Gladi-vae/Project-Team-A---Taquin/Images/AI.png

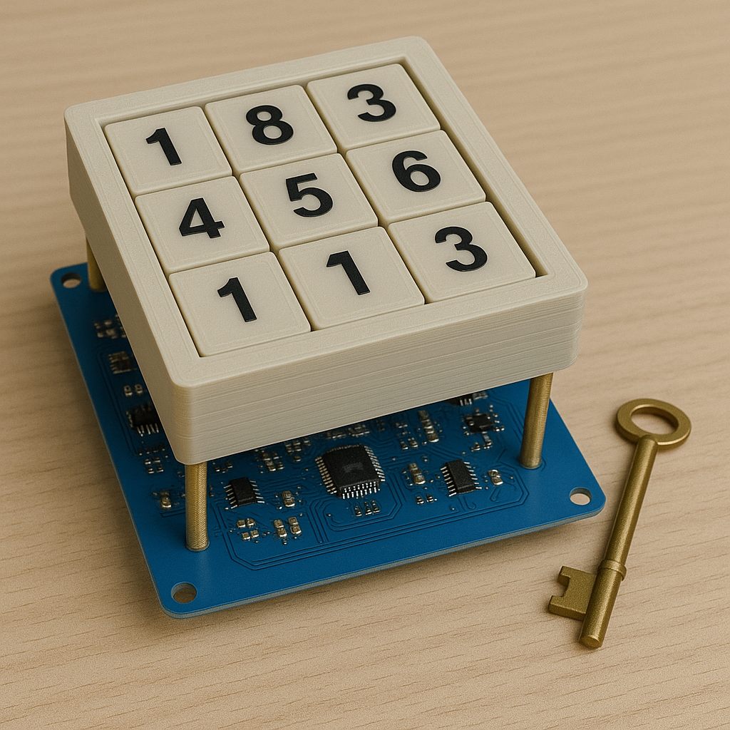
Images/AI.png
