Gladi-vae/Project-Team-A---Taquin/(commit log)

2025-05-25 Rename Taquin.png to jeu de taquin.png
2025-05-25 Rename jeu de taquin.png to Jeu de taquin.png
2025-05-25 Rename Jeu de taquin.png to taquin.png
